abaeljoseph/reconDrone/docs/images/ir-and-thermal.jpg

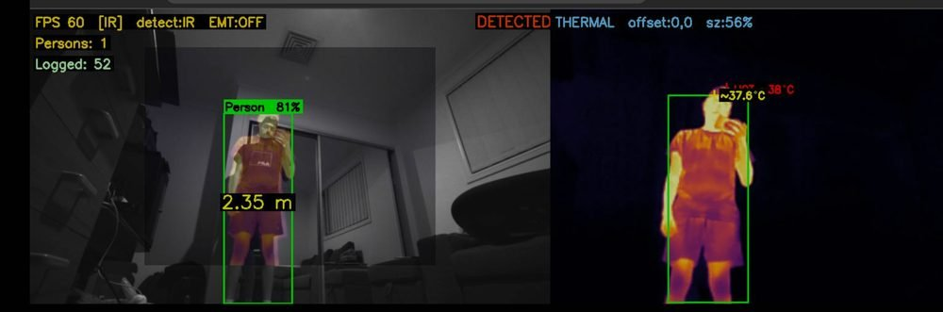
docs/images/ir-and-thermal.jpg
