abaeljoseph/reconDrone/docs/images/temperatures.png

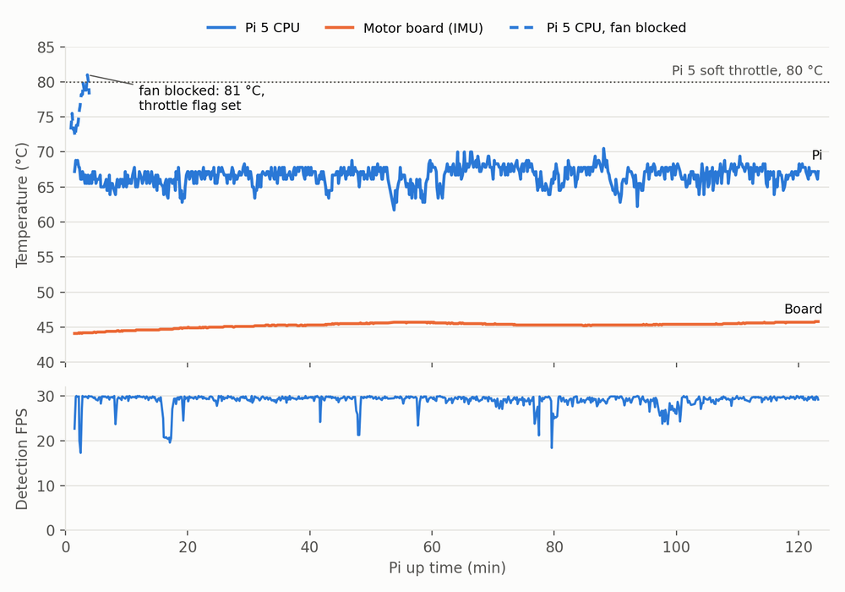
docs/images/temperatures.png
