abaeljoseph/reconDrone/Recon Drone Progress Photos/RealSense D435 — Colour_screenshot_03.04.2026 Over 1m detection rgb.png

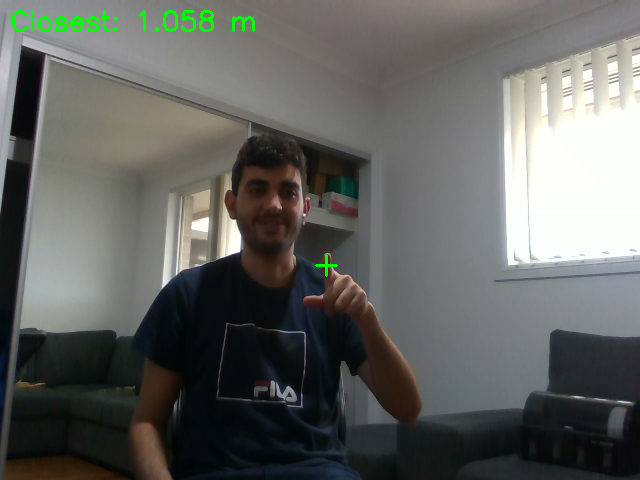
Recon Drone Progress Photos/RealSense D435 — Colour_screenshot_03.04.2026 Over 1m detection rgb.png
