abaeljoseph/reconDrone/Recon Drone Progress Photos/RealSense D435 — Depth_screenshot_03.04.2026 depth over 1m.png

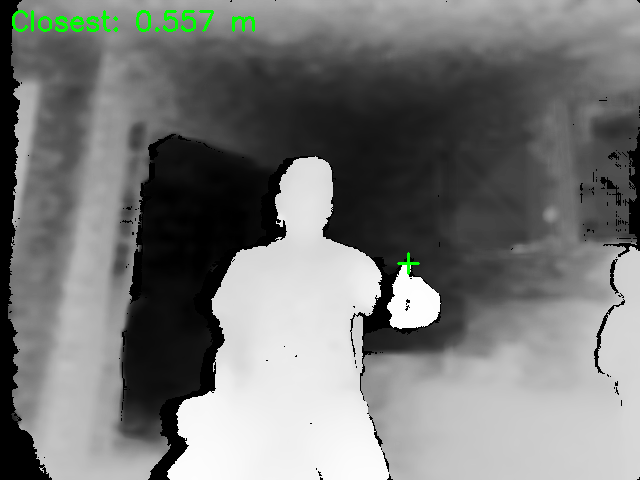
Recon Drone Progress Photos/RealSense D435 — Depth_screenshot_03.04.2026 depth over 1m.png
