abaeljoseph/reconDrone/Recon Drone Progress Photos/RealSense D435 — Infrared_screenshot_03.04.2026.png

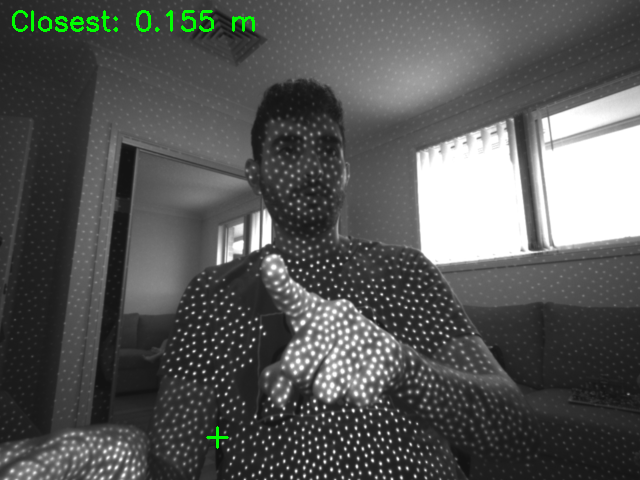
Recon Drone Progress Photos/RealSense D435 — Infrared_screenshot_03.04.2026.png
