abaeljoseph/reconDrone/Recon Drone Progress Photos/RealSense D435 — YOLOv8n-pose_screenshot_15.05.26.png

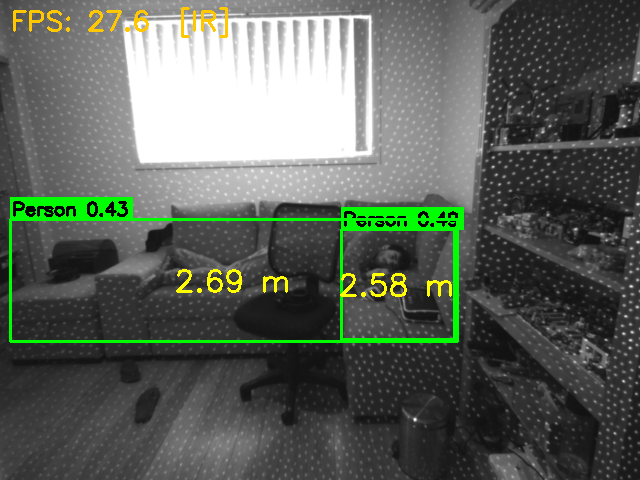
Recon Drone Progress Photos/RealSense D435 — YOLOv8n-pose_screenshot_15.05.26.png
