abaeljoseph/reconDrone/Recon Drone Progress Photos/Recon Drone — Human Detection_screenshot_27.05.2026.png

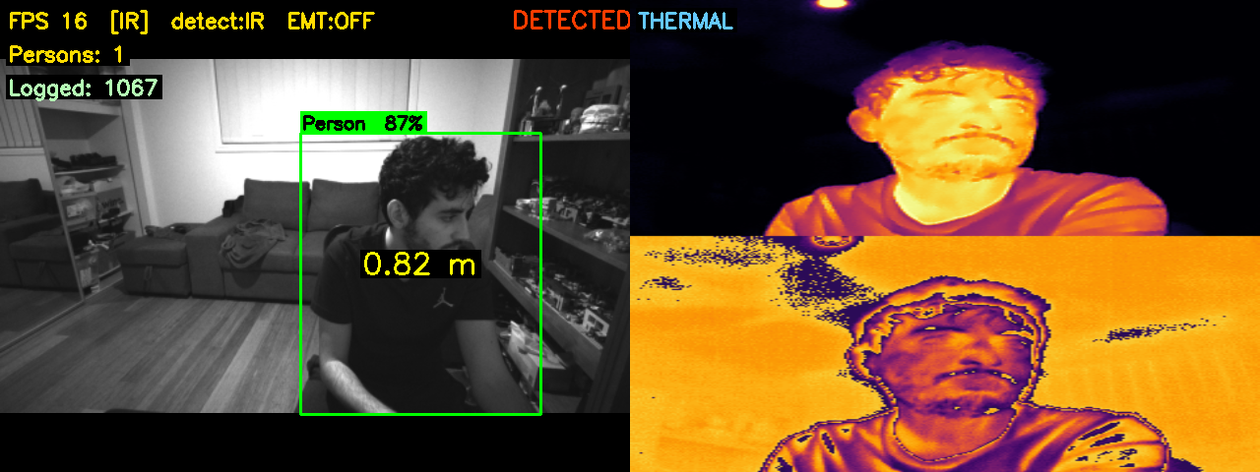
Recon Drone Progress Photos/Recon Drone — Human Detection_screenshot_27.05.2026.png
