abaeljoseph/reconDrone/(commit log)

2026-10-23 Initial commit — Recon Drone Human Detection System
    YOLOv8n-pose NCNN inference on Raspberry Pi 5 with Intel RealSense D435
    and Victor 328B thermal camera. Dual IR/RGB streams, thermal overlay,
    lying-down rotated inference, hotspot detection, CSV logging.
2026-10-23 Checkpoint: Pi detection code
    Updated realsense_yolo.py and README, power_monitor.py, usb_check.py,
    ncnn_pose.py, 169 and rotated pose NCNN models.
2026-10-23 Checkpoint: drive firmware and Pi drive driver
    drive/drive_fw: ESP32 (MKS ESP32 FOC V2.0) dual BLDC velocity control,
    serial V/S protocol, 20 Hz telemetry, GY-521 IMU on software I2C.
    drive/pi/drive.py: Pi-side driver with odometry. drive/tools: bench
    flash, monitor and drive test scripts. Bring-up test sketches.
2026-11-04 Add the latest drone code
    Web app, thermal fusion, LEDs, test script, services and current firmware.
    The home WiFi name is replaced by a placeholder.
    [drive.py, drive_fw.ino, fw_update.py, leds.py, md_net.py, report_tests.py, thermal.py, web.py]
